Harshith0308/emisense/analysis/amplitude_by_class.png

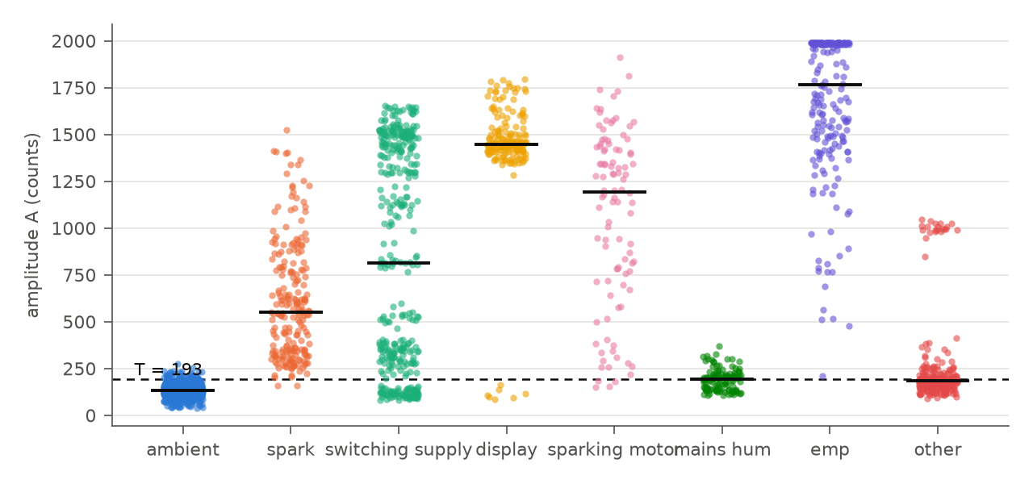
analysis/amplitude_by_class.png
