Harshith0308/emisense/analysis/envelopes_by_class.png

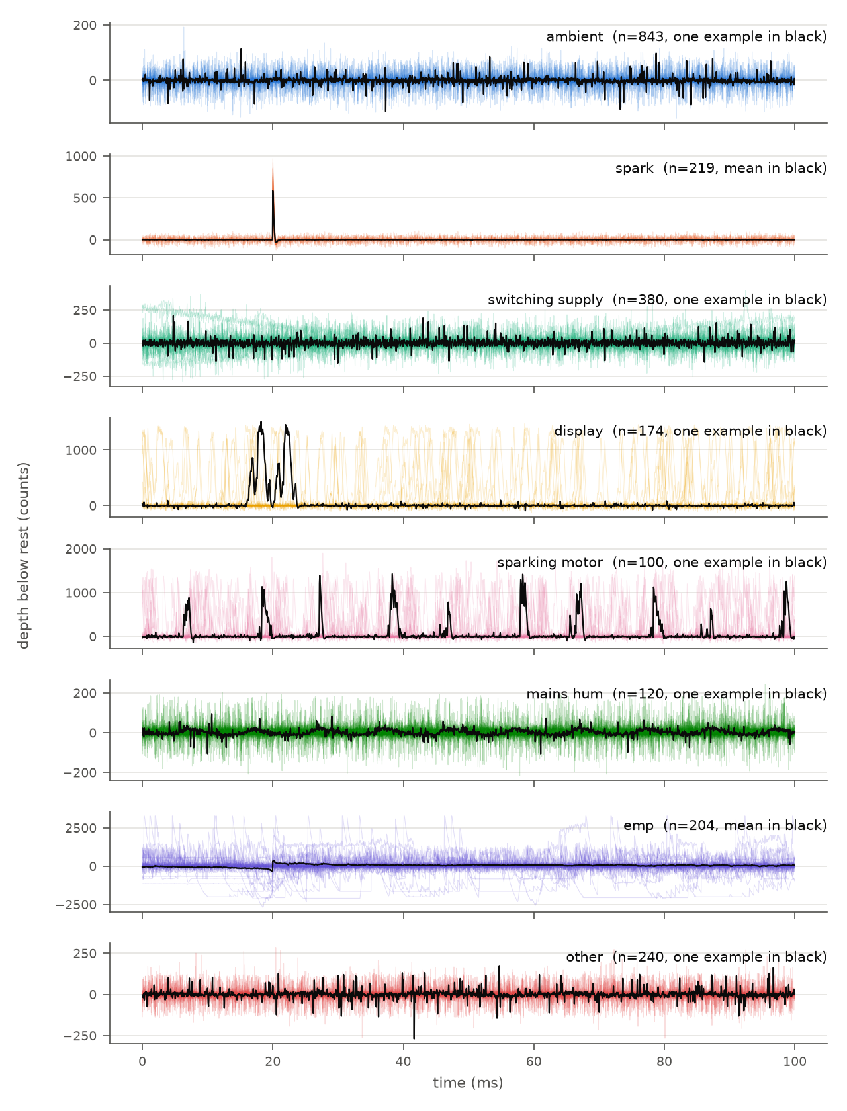
analysis/envelopes_by_class.png
